jlpoltrack/MCP251863Breakout/MCP251863Breakout.pdf

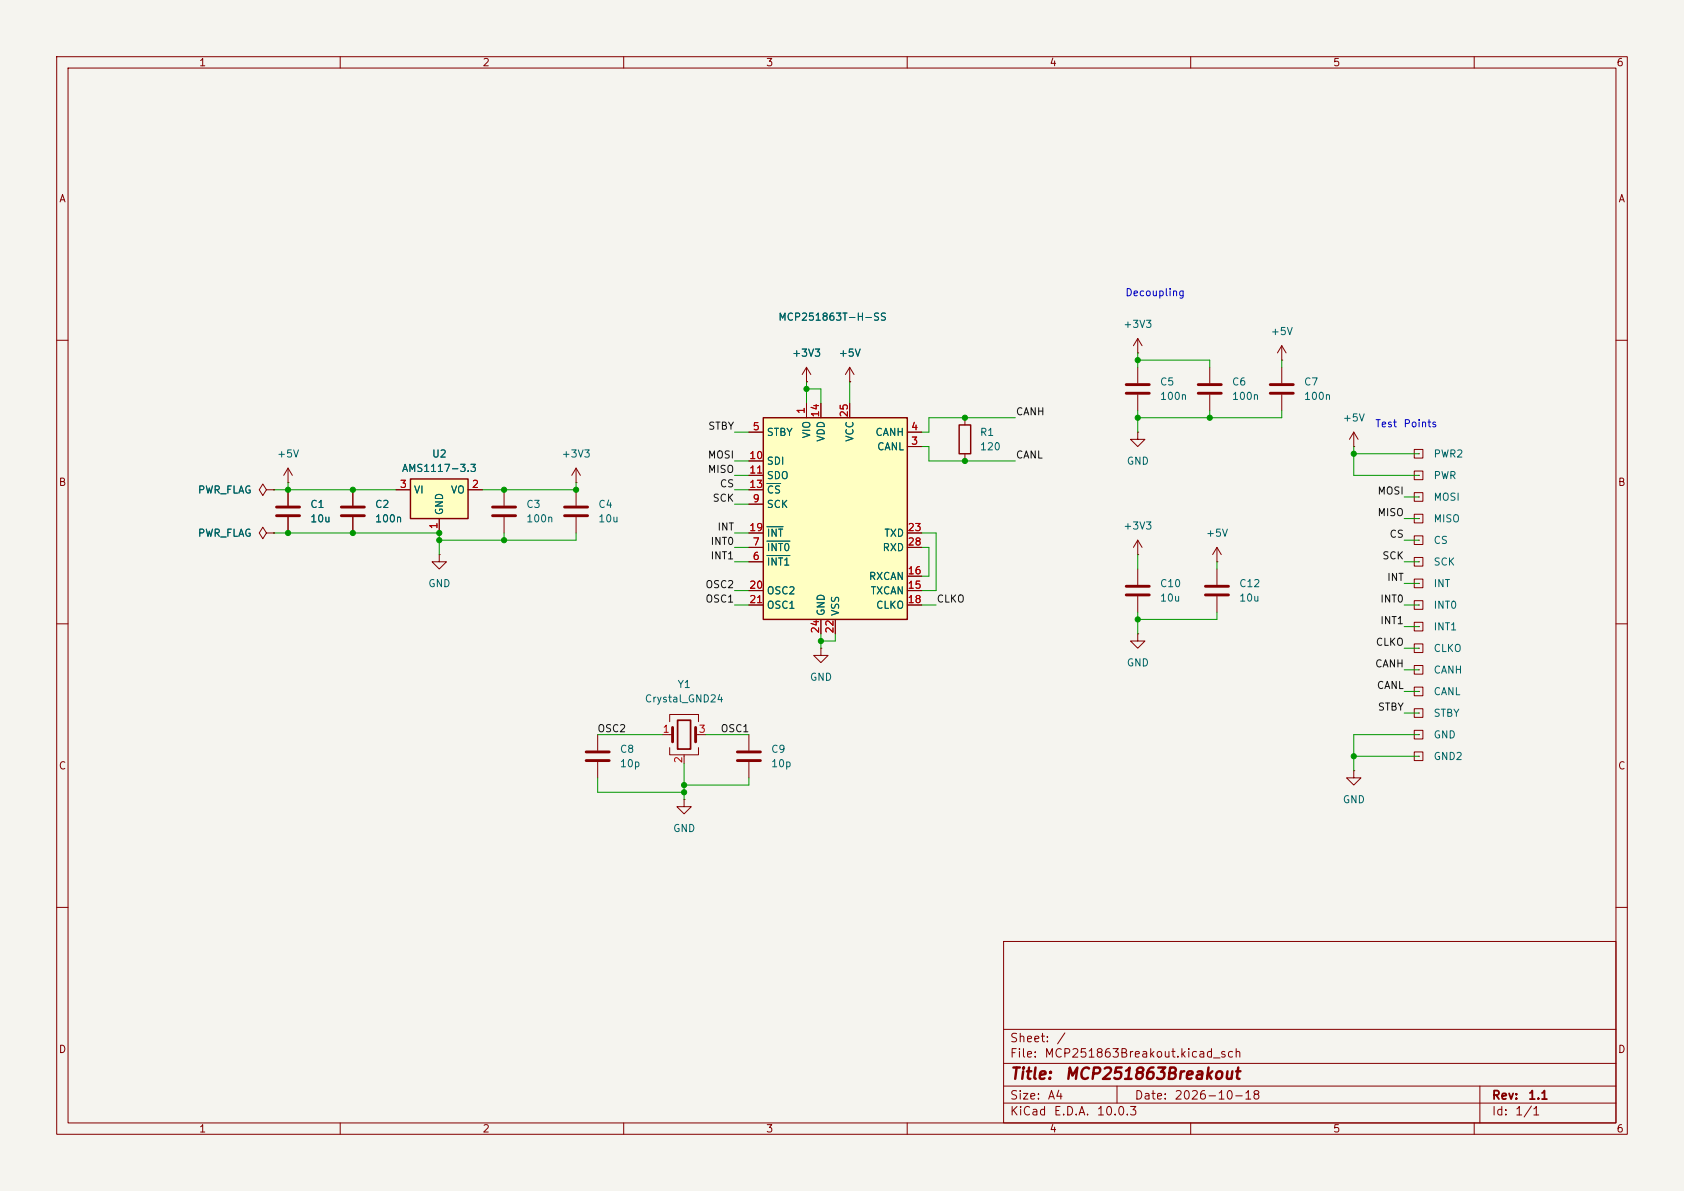
[picture p3: page 1]

INT STBY CANL CANH

Size: A4 | Rev: 1.1
KiCad E.D.A. 10.0.3 | Id: 1/1
