jlpoltrack/MCP251863Breakout/MCP251863Breakout.kicad_pcb

## KiCad design MCP251863Breakout.kicad_pcb (2026-10-18)

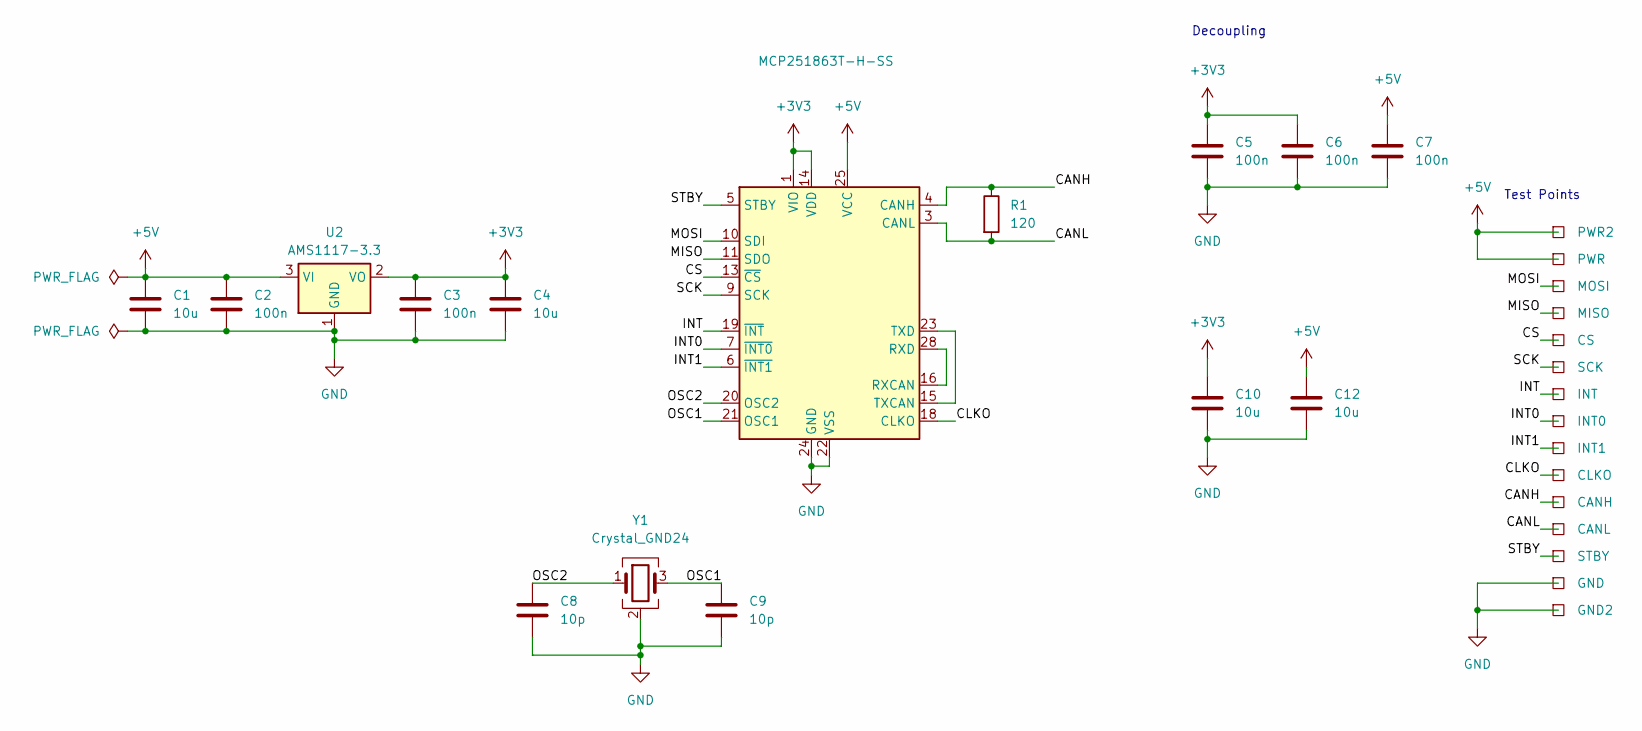
[picture p4: schematic MCP251863Breakout.kicad_sch]

Parts:
C1, C4, C10, C12: 10u; C_0603_1608Metric_Pad1.08x0.95mm_HandSolder; LCSC Part C96446
C2, C3, C5, C6, C7: 100n; C_0603_1608Metric_Pad1.08x0.95mm_HandSolder; LCSC Part C14663
C8, C9: 10p; C_0603_1608Metric_Pad1.08x0.95mm_HandSolder; LCSC Part C1634
CANH: TestPoint_Square; TestPoint_Pad_2.0x2.0mm
CANL: TestPoint_Square; TestPoint_Pad_2.0x2.0mm
CLKO: TestPoint_Square; TestPoint_Pad_2.0x2.0mm
CS: TestPoint_Square; TestPoint_Pad_2.0x2.0mm
GND, GND2: TestPoint_Square; TestPoint_Pad_2.0x2.0mm
INT, INT0, INT1: TestPoint_Square; TestPoint_Pad_2.0x2.0mm
MISO: TestPoint_Square; TestPoint_Pad_2.0x2.0mm
MOSI: TestPoint_Square; TestPoint_Pad_2.0x2.0mm
PWR, PWR2: TestPoint_Square; TestPoint_Pad_2.0x2.0mm
R1: 120; C_0603_1608Metric_Pad1.08x0.95mm_HandSolder; LCSC Part C22787
SCK: TestPoint_Square; TestPoint_Pad_2.0x2.0mm
STBY: TestPoint_Square; TestPoint_Pad_2.0x2.0mm
U1: MCP251863T-H-SS; SSOP-28_5.3x10.2mm_P0.65mm
U2: AMS1117-3.3; SOT-223-3_TabPin2; LCSC Part C6186
Y1: Crystal_GND24; Crystal_SMD_2016-4Pin_2.0x1.6mm

Connections:
+3V3: C3.1, C4.1, C5.1, C6.1, C10.1, U1.1 (VIO), U1.14 (VDD), U2.2 (VO)
+5V: C1.1, C2.1, C7.1, C12.1, PWR.1 (1_1), PWR2.1 (1_1), U1.25 (VCC), U2.3 (VI)
/CANH: CANH.1 (1_1), R1.1, U1.4 (CANH)
/CANL: CANL.1 (1_1), R1.2, U1.3 (CANL)
/CLKO: CLKO.1 (1_1), U1.18 (CLKO)
/CS: CS.1 (1_1), U1.13 (~CS)
/INT: INT.1 (1_1), U1.19 (~INT)
/INT0: INT0.1 (1_1), U1.7 (~INT0)
/INT1: INT1.1 (1_1), U1.6 (~INT1)
/MISO: MISO.1 (1_1), U1.11 (SDO)
/MOSI: MOSI.1 (1_1), U1.10 (SDI)
/OSC1: C9.1, U1.21 (OSC1), Y1.3
/OSC2: C8.1, U1.20 (OSC2), Y1.1
/SCK: SCK.1 (1_1), U1.9 (SCK)
/STBY: STBY.1 (1_1), U1.5 (STBY)
GND: C1.2, C2.2, C3.2, C4.2, C5.2, C6.2, C7.2, C8.2, C9.2, C10.2, C12.2, GND.1 (1_1), GND2.1 (1_1), U1.22 (VSS), U1.24 (GND), U2.1 (GND), Y1.2 (G), Y1.4 (G)
unnamed: U1.16 (RXCAN), U1.28 (RXD)
unnamed: U1.15 (TXCAN), U1.23 (TXD)

Notes on the sheet:
Decoupling
Test Points

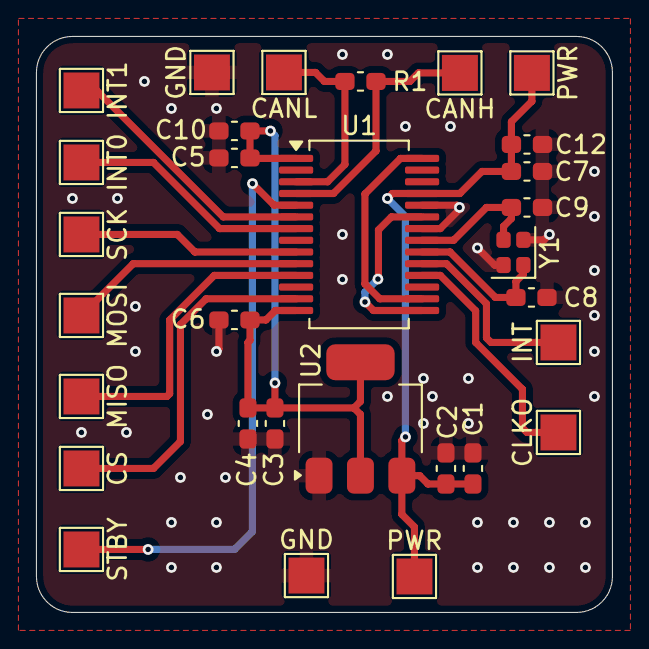
[picture p5: board MCP251863Breakout.kicad_pcb from above]

Board: 2 copper layers, 32.0 x 32.0 mm, 30 parts (0 on the bottom side), 18 nets.
