jlpoltrack/MCP251863Breakout/(commit log)

2026-10-18 Initial commit: KiCad project, schematic PDF, renders, production files, and README
    [MCP251863Breakout.kicad_pcb, MCP251863Breakout.kicad_sch, bom.csv, designators.csv, positions.csv]
2026-10-18 Break out STBY to a pad, add GND/PWR pads beside CANL/CANH, set LCSC basic parts
    - U1 STBY (pin 5) no longer tied to GND: new STBY pad below CS, routed on B.Cu
    - GND2 left of CANL, PWR2 (+5V, to C12) right of CANH
    - LCSC: C96446 10u, C14663 100n, C1634 10p, C22787 120R, C6186 AMS1117
    - Schematic test-pad refs match the board (clears parity), rev 1.1
    - Regenerated production files, PDF, renders, README
    [MCP251863Breakout.kicad_pcb, MCP251863Breakout.kicad_sch, bom.csv, designators.csv, positions.csv]
2026-10-24 README: drop board dimensions and the 2-layer note; match USBGPIB-STM32's layout
